tug-g/universal-projects/miniweatherstation/3d models/windvanecap.stl

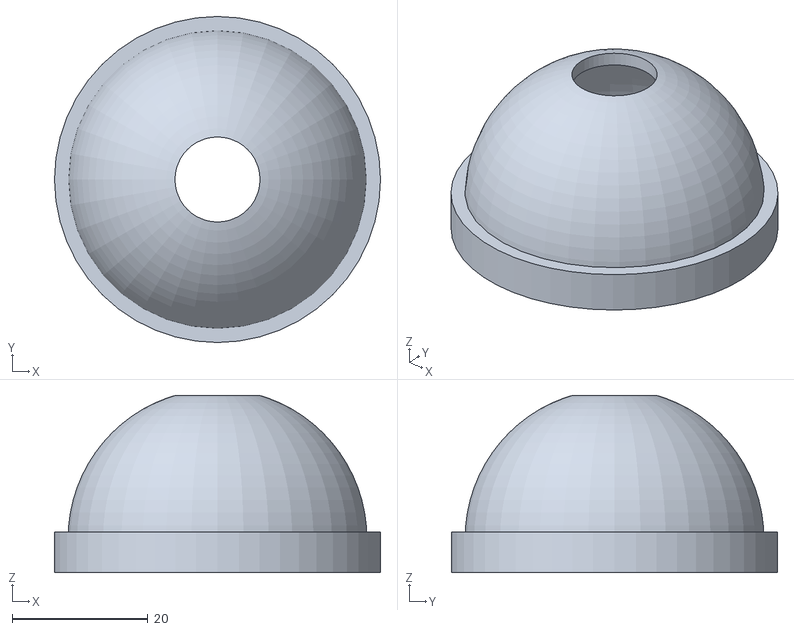
[picture p18: CAD file, 2026-02-19]
miniweatherstation/3d models/windvanecap.stl
48.0 x 48.0 x 26.1
