tug-g/universal-projects/miniweatherstation/3d models/windvanetailholder.stl

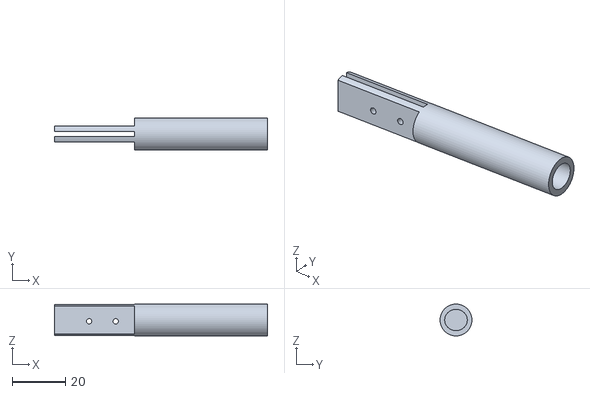
[picture p19: CAD file, 2026-02-19]
miniweatherstation/3d models/windvanetailholder.stl
80.0 x 12.0 x 12.0
