tug-g/universal-projects/miniweatherstation/3d models/windvanearrow.stl

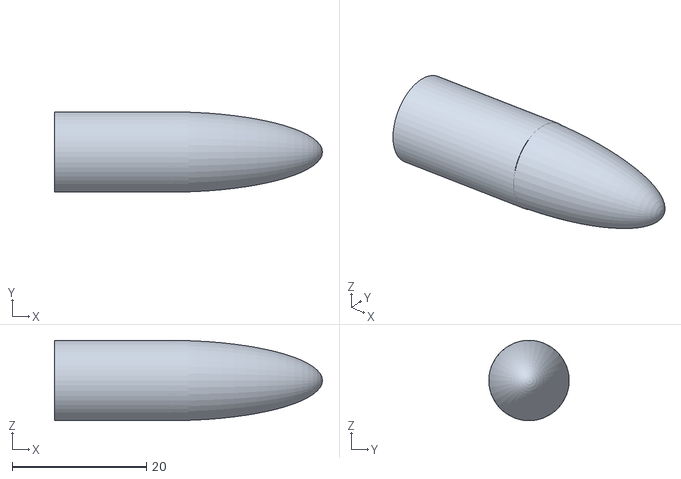
[picture p20: CAD file, 2026-02-19]
miniweatherstation/3d models/windvanearrow.stl
40.0 x 12.0 x 12.0
