tug-g/universal-projects/miniweatherstation/3d models/windvanebottom.stl

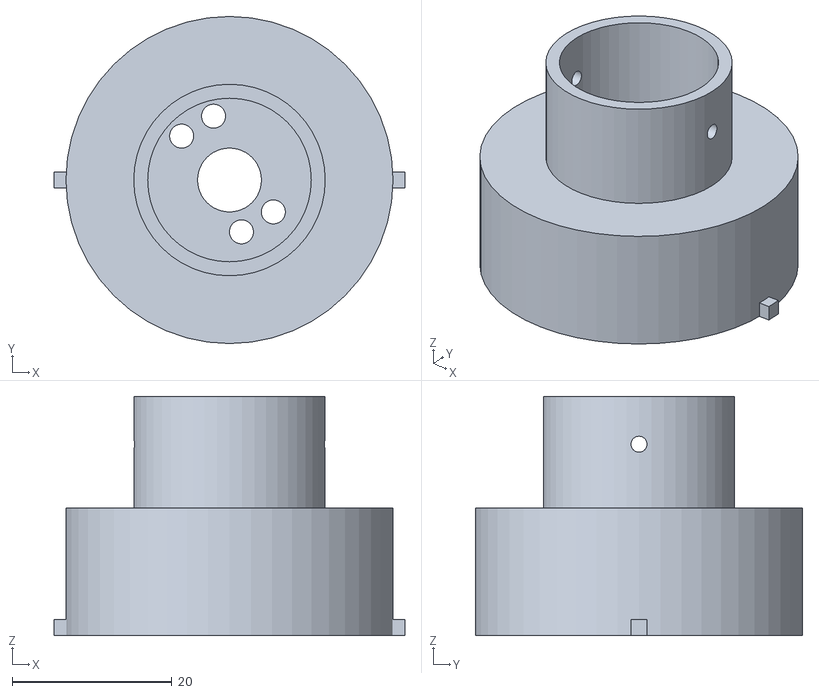
[picture p21: CAD file, 2026-02-19]
miniweatherstation/3d models/windvanebottom.stl
44.0 x 41.0 x 30.0
