tug-g/universal-projects/miniweatherstation/3d models/fanbearingholder.stl

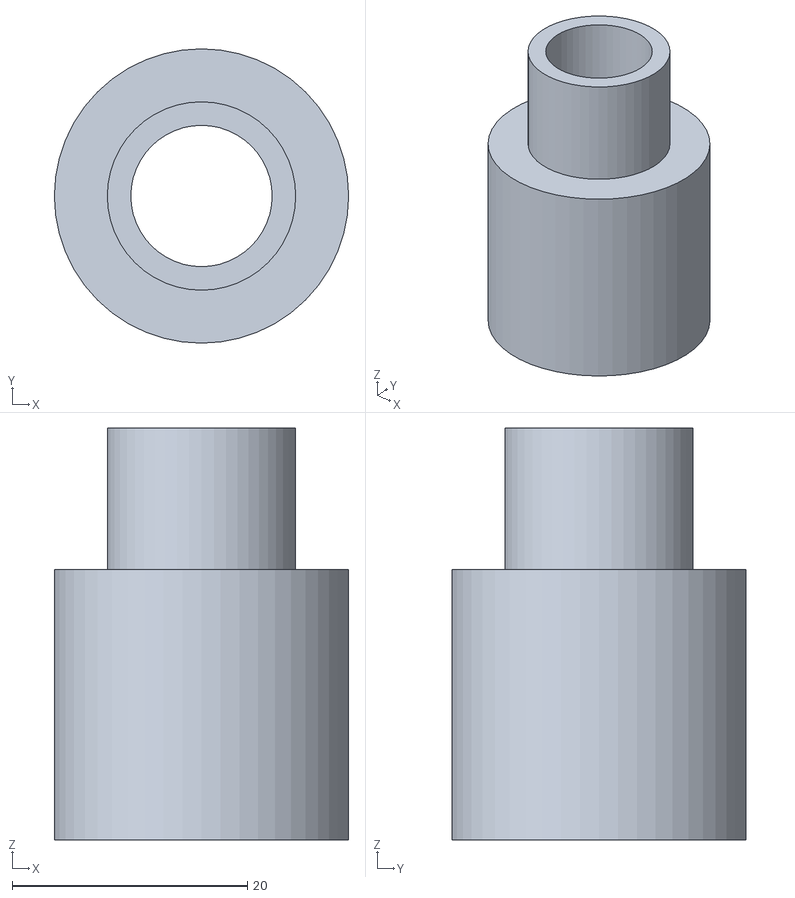
[picture p22: CAD file, 2026-02-19]
miniweatherstation/3d models/fanbearingholder.stl
25.0 x 25.0 x 35.0
