tug-g/universal-projects/miniweatherstation/3d models/windvanecenter.stl

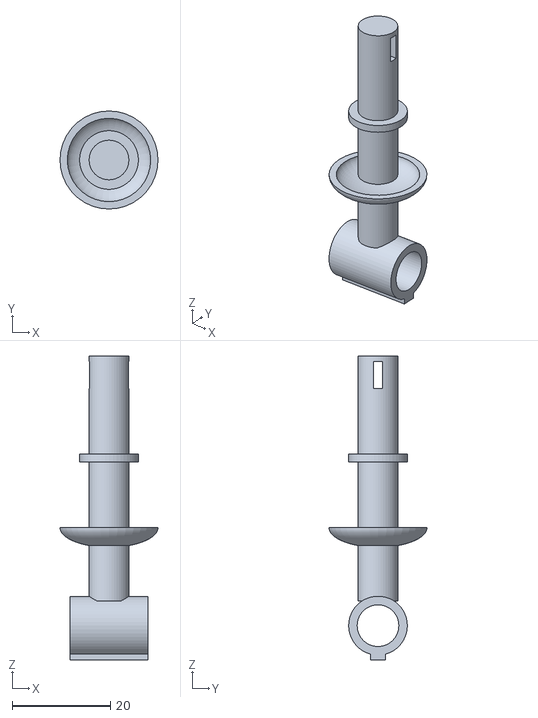
[picture p23: CAD file, 2026-02-19]
miniweatherstation/3d models/windvanecenter.stl
20.0 x 20.0 x 62.0
