tug-g/universal-projects/miniweatherstation/3d models/fancup.stl

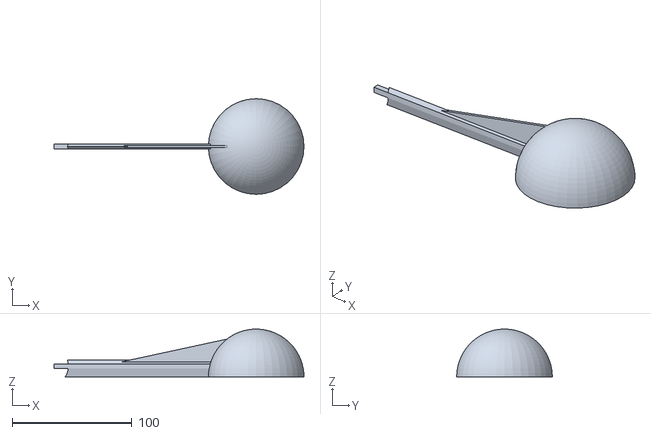
[picture p24: CAD file, 2026-02-19]
miniweatherstation/3d models/fancup.stl
209.0 x 80.0 x 40.0
