tug-g/universal-projects/miniweatherstation/3d models/windvanebearingholder.stl

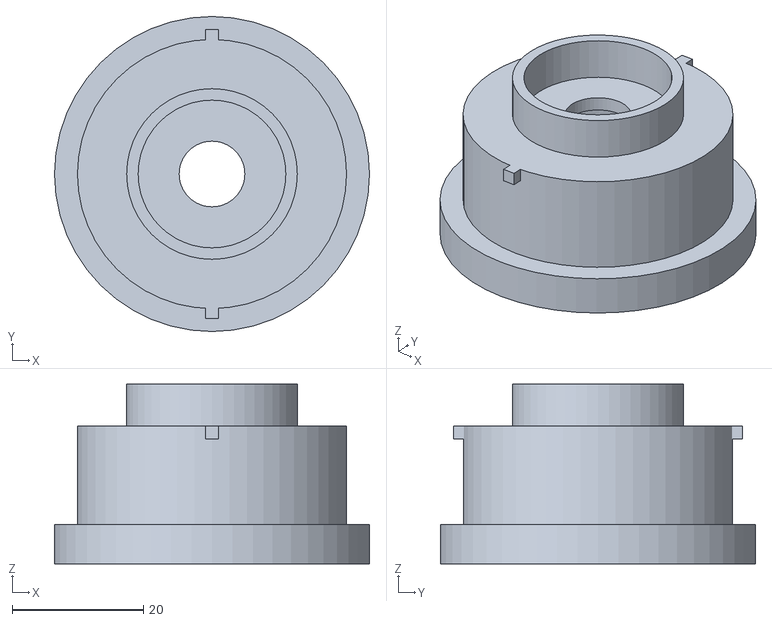
[picture p25: CAD file, 2026-02-19]
miniweatherstation/3d models/windvanebearingholder.stl
48.0 x 48.0 x 27.4
