tug-g/universal-projects/miniweatherstation/3d models/windvanespine.stl

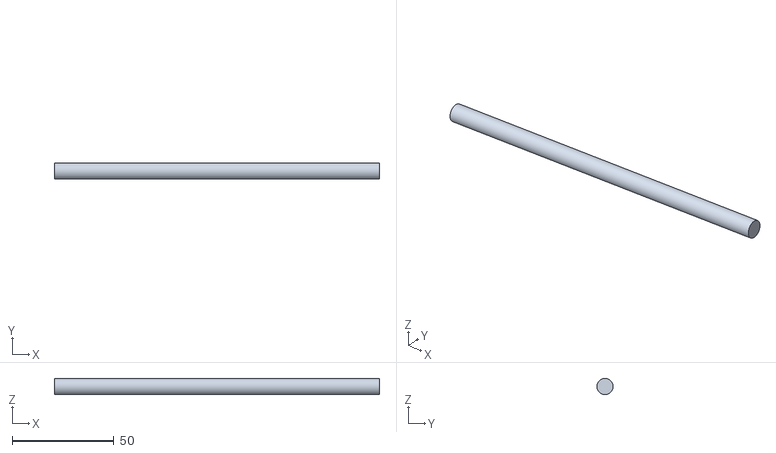
[picture p26: CAD file, 2026-02-19]
miniweatherstation/3d models/windvanespine.stl
160.0 x 8.00 x 8.00
