tug-g/universal-projects/miniweatherstation/3d models/fancenter.stl

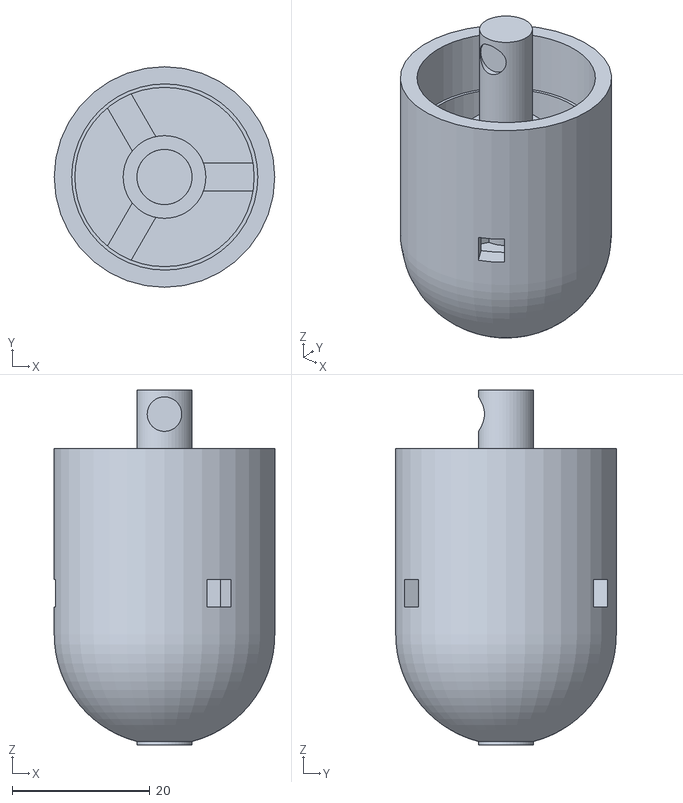
[picture p27: CAD file, 2026-02-19]
miniweatherstation/3d models/fancenter.stl
32.0 x 32.0 x 51.5
