tug-g/universal-projects/miniweatherstation/datastuffs/Location one.pdf

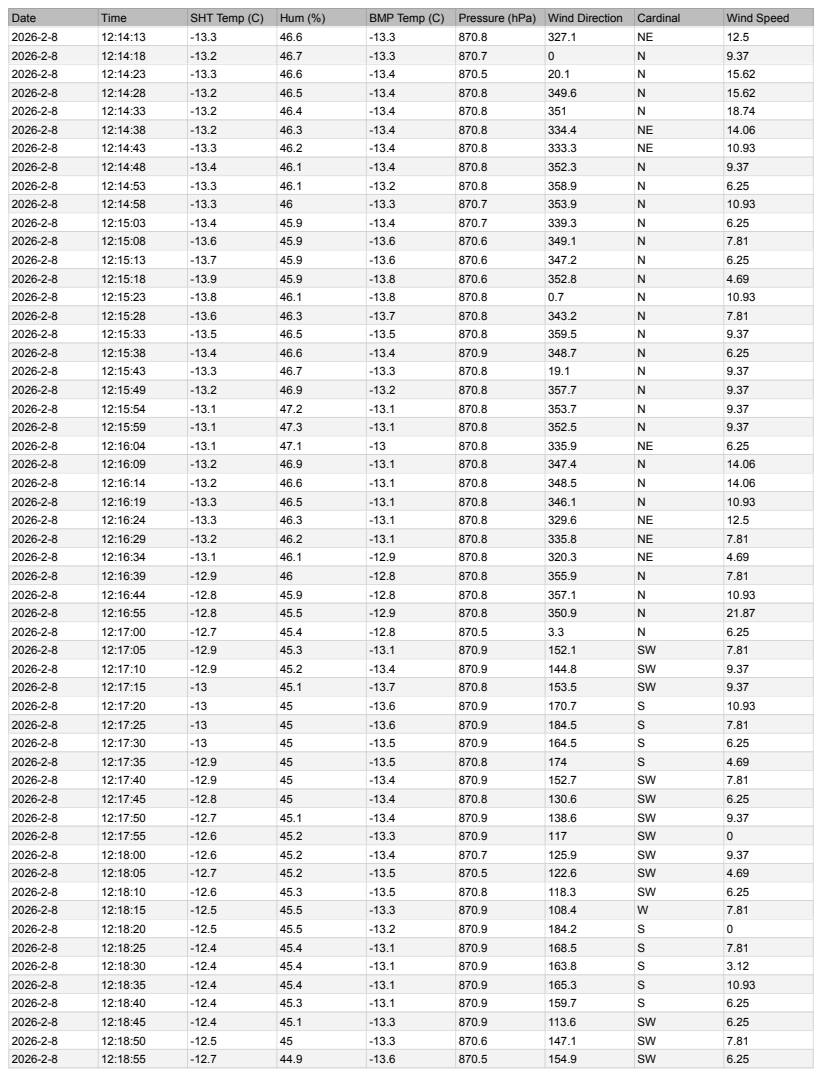
[picture p28: page 1]
Date; Time; SHT Temp (C); Hum (%); BMP Temp (C); Pressure (hPa) Wind Direction; Cardinal; Wind Speed

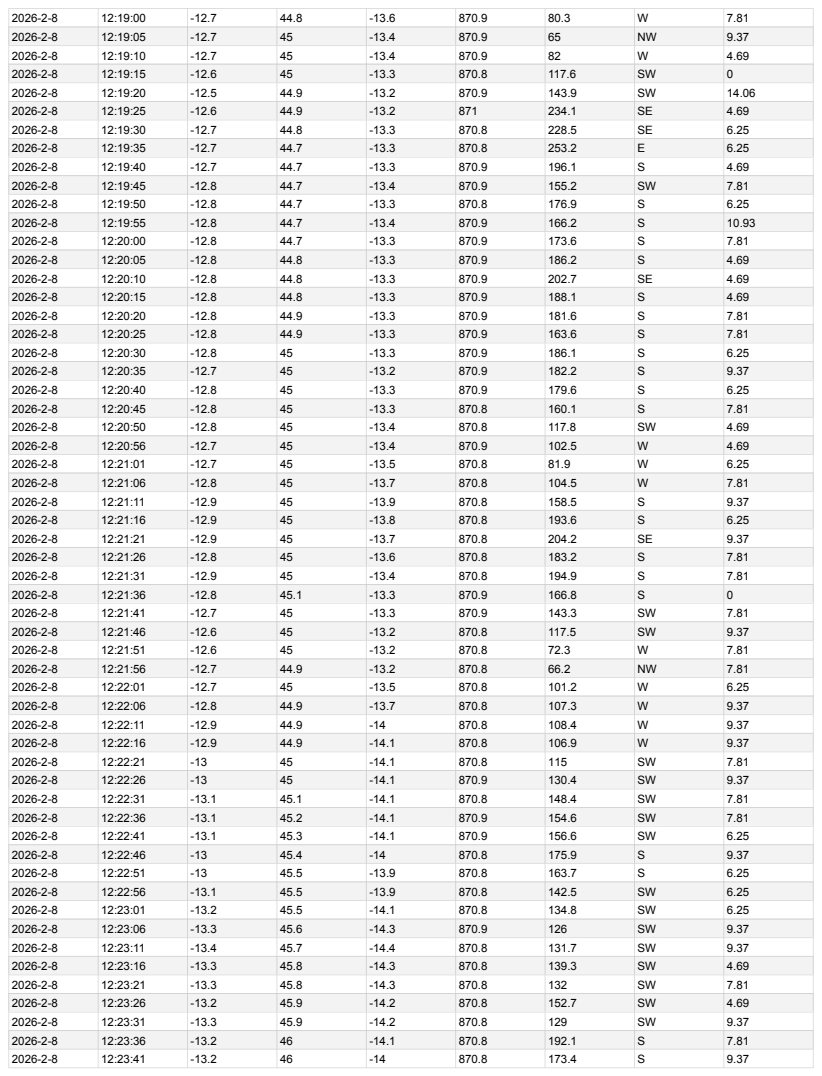
[picture p29: page 2]

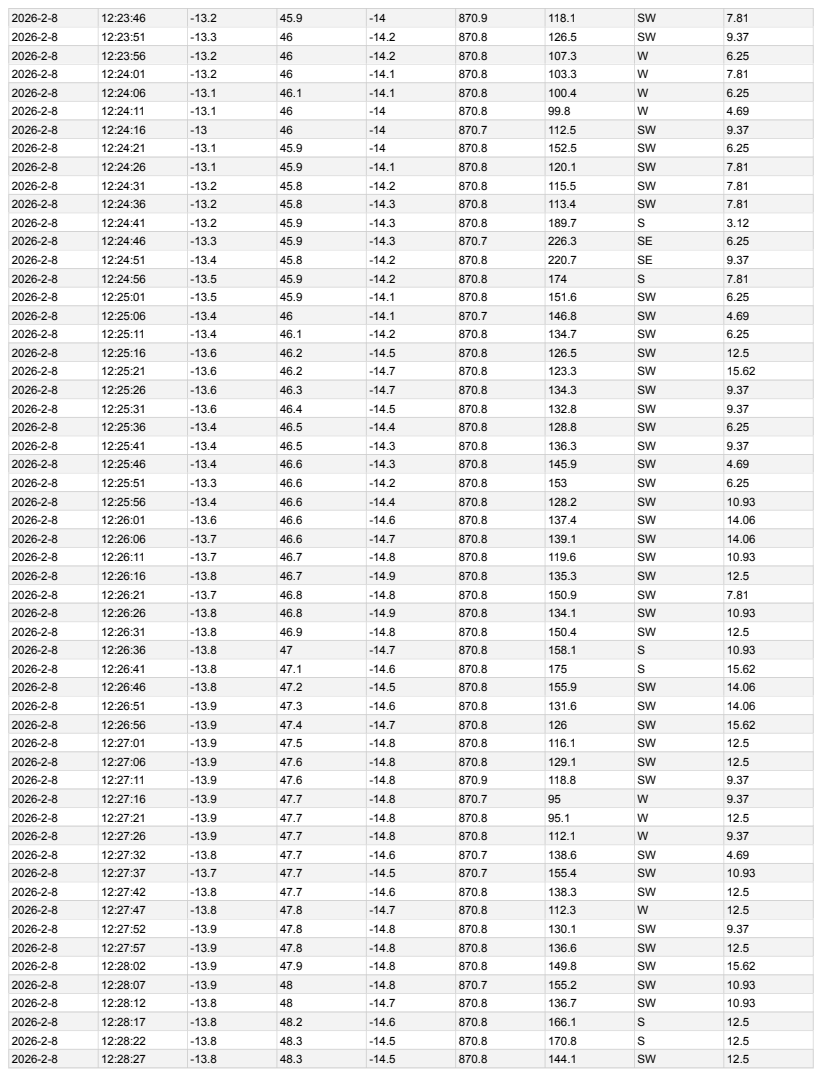
[picture p30: page 3]

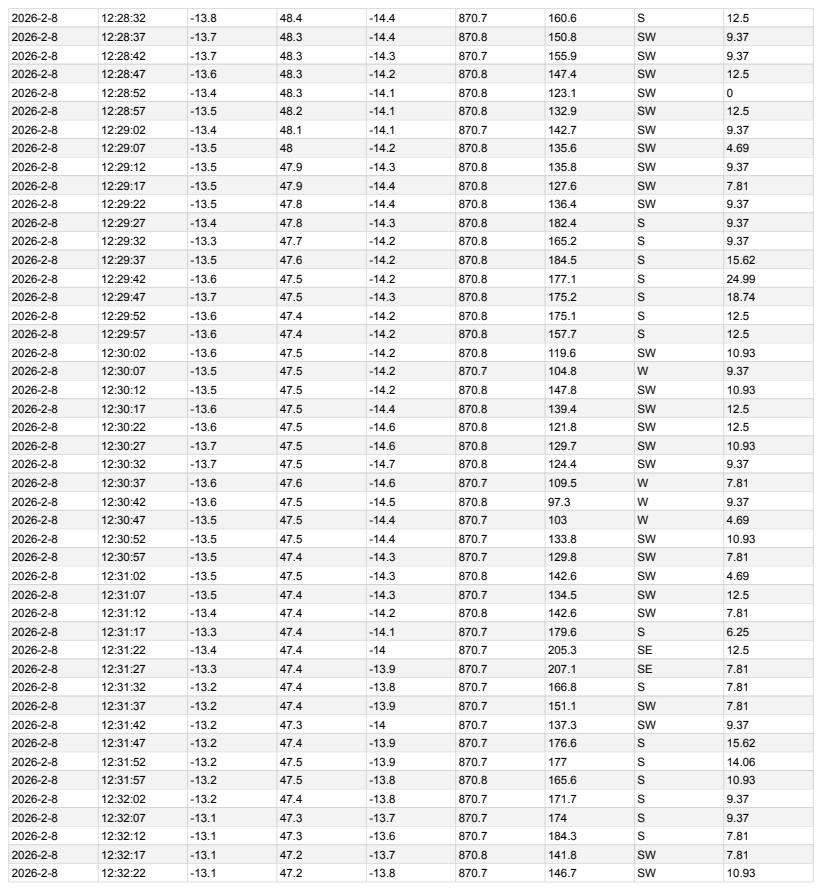
[picture p31: page 4]
