tug-g/universal-projects/miniweatherstation/datastuffs/Location two.pdf

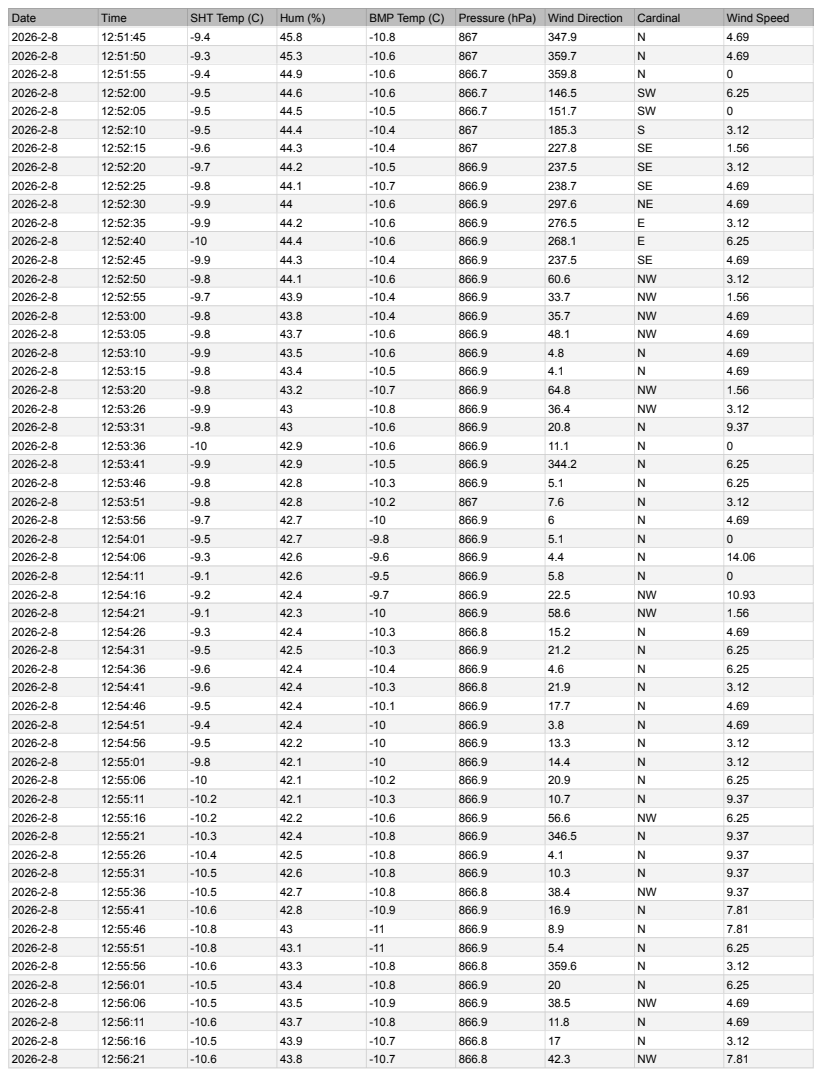
[picture p32: page 1]
Date; Time; SHT Temp (C); Hum (%); BMP Temp (C); Pressure (hPa) Wind Direction; Cardinal; Wind Speed

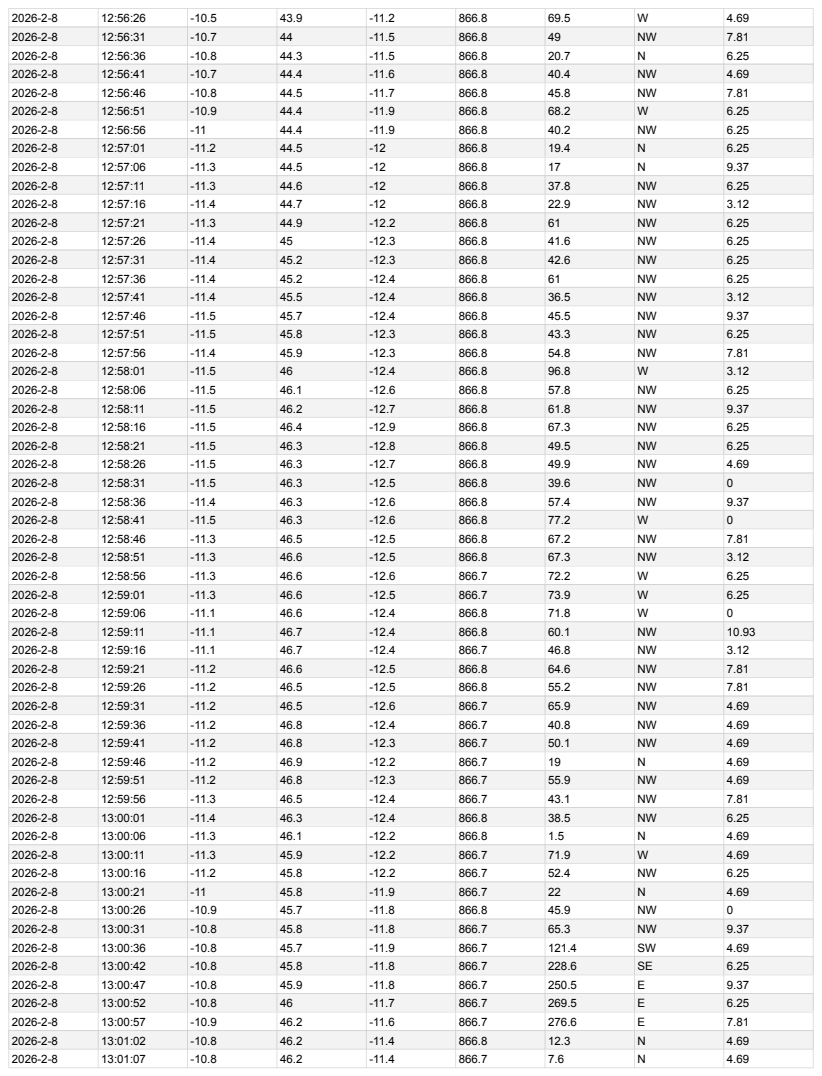
[picture p33: page 2]

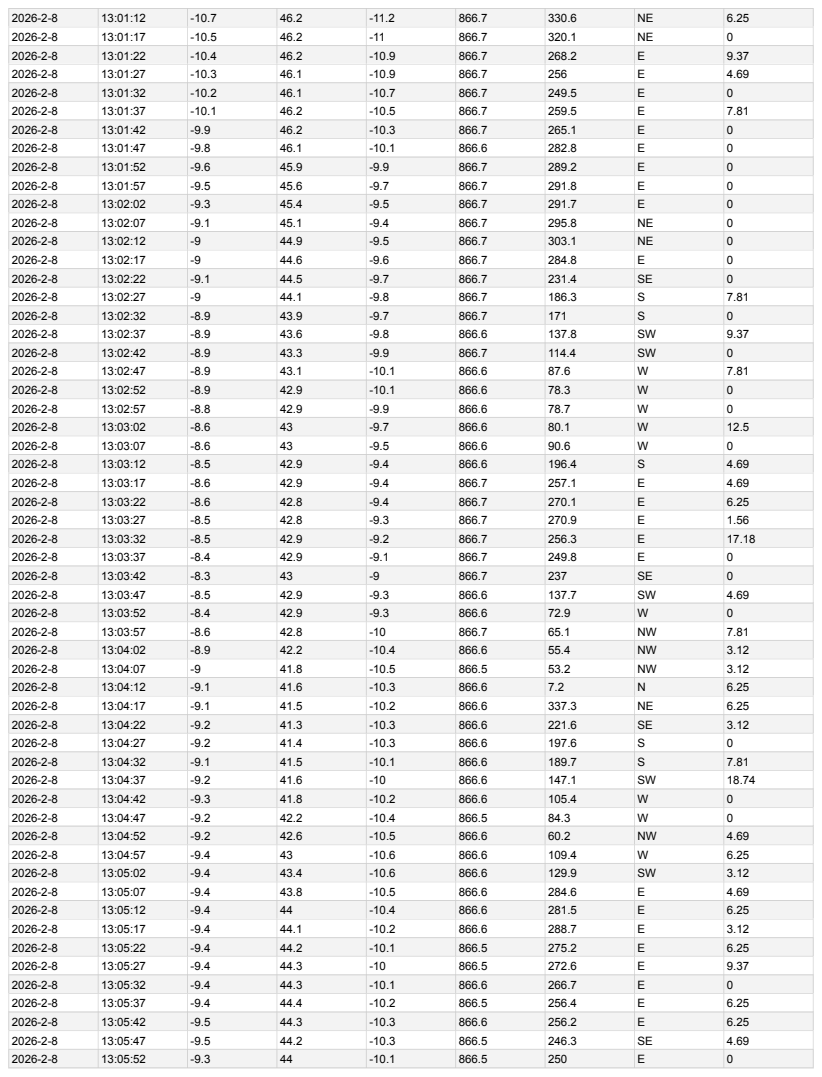
[picture p34: page 3]

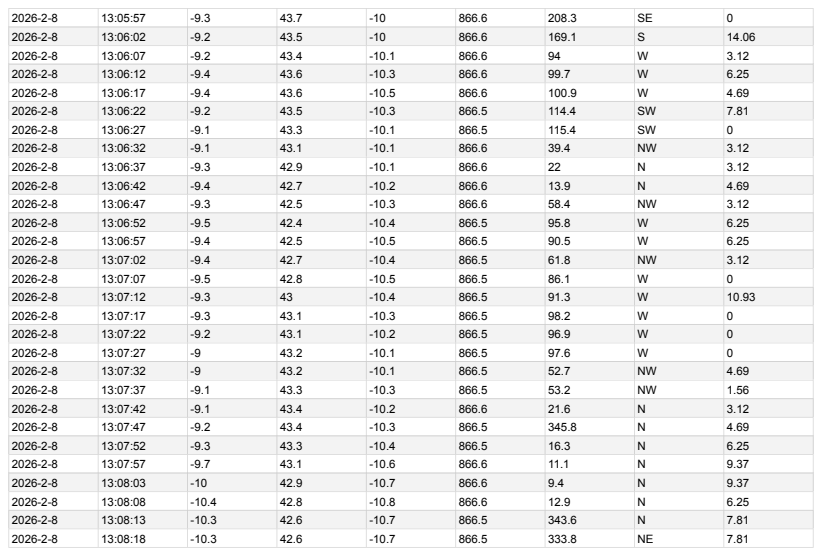
[picture p35: page 4]
